zachdeibert/radio-tracker/BOM.xlsx

Part | Part No | Price | Qty Base | Qty Beacon | Qty Extra | Price Base | Price Beacon | Price Extra | Order Link | Datasheet Link
Barometer | MS5637 | $3.40 |  |  | 1 | $0.00 | $0.00 | $3.40 | https://www.digikey.com/product-detail/en/te-connectivity-measurement-specialties/MS563702BA03-50/223-1199-1-ND/4700922 | https://www.te.com/commerce/DocumentDelivery/DDEController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
MCU | ATTINY85 | $0.69 |  | 1 |  | $0.00 | $0.69 | $0.00 | https://www.digikey.com/product-detail/en/microchip-technology/ATTINY85V-15MT/1611-ATTINY85V-15MTCT-ND/6833275 | http://ww1.microchip.com/downloads/en/DeviceDoc/Atmel-7598_Automotive-Microcontrollers-ATtiny25-45-85_Datasheet.pdf
Transmitter | Si4012 | $1.04 |  | 1 |  | $0.00 | $1.04 | $0.00 | https://www.digikey.com/product-detail/en/silicon-labs/SI4012-C1001GTR/336-4153-1-ND/7650432 | https://www.silabs.com/documents/public/data-sheets/Si4012.pdf
Amplifier | MAAL-010704 | $2.83 |  | 1 |  | $0.00 | $2.83 | $0.00 | https://www.digikey.com/product-detail/en/m-a-com-technology-solutions/MAAL-010704-TR3000/1465-1261-1-ND/4429958 | http://cdn.macom.com/datasheets/MAAL-010704.pdf
Buck Converter | AOZ6662D1 | $0.43 | 1 | 1 |  | $0.43 | $0.43 | $0.00 | https://www.digikey.com/product-detail/en/alpha-omega-semiconductor-inc/AOZ6662DI/785-1856-1-ND/10258154 | http://www.aosmd.com/res/data_sheets/AOZ6662DI.pdf
50R Balun | ABT-8 | $0.69 |  | 2 |  | $0.00 | $1.38 | $0.00 | https://www.digikey.com/product-detail/en/abracon-llc/ABT-8-50-1-T/535-12760-1-ND/5043447 | https://abracon.com/Magnetics/balun/ABT-8.pdf
75R Balun | ABT-8 | $0.69 |  |  |  | $0.00 | $0.00 | $0.00 | https://www.digikey.com/product-detail/en/abracon-llc/ABT-8-75-2-T/535-12761-1-ND/5043448 | https://abracon.com/Magnetics/balun/ABT-8.pdf
NPN BJT | MMBT3904 | $0.10 | 1 |  | 1 | $0.10 | $0.00 | $0.10 | https://www.digikey.com/product-detail/en/nexperia-usa-inc/MMBT3904-215/1727-4044-1-ND/1944320 | https://assets.nexperia.com/documents/data-sheet/MMBT3904.pdf
Piezo Buzzer | AT-1224-TWT-5V-2-R | $0.61 | 1 |  | 1 | $0.61 | $0.00 | $0.61 | https://www.digikey.com/product-detail/en/pui-audio-inc/AT-1224-TWT-5V-2-R/668-1470-ND/5011404 | http://www.puiaudio.com/pdf/AT-1224-TWT-5V-2-R.pdf
10-13 MHz Crystal | RH100 | $0.38 |  |  | 1 | $0.00 | $0.00 | $0.38 | https://www.digikey.com/product-detail/en/raltron-electronics/RH100-12-000-12-1010-EXT-TR/2151-RH100-12-000-12-1010-EXT-TRCT-ND/10272643 | http://www.raltron.com/wp-content/uploads/2017/08/RH100_SERIES-August-2017.pdf
Copper Tape | 3483 | $4.95 | 1 |  |  | $4.95 | $0.00 | $0.00 | https://www.digikey.com/product-detail/en/adafruit-industries-llc/3483/1528-2748-ND/9745247 | https://media.digikey.com/pdf/Data%20Sheets/Adafruit%20PDFs/3483_Web.pdf
Card Edge Connector | 5-5530843-0 | $1.98 | 1 |  |  | $1.98 | $0.00 | $0.00 | https://www.digikey.com/product-detail/en/te-connectivity-amp-connectors/5-5530843-0/A31722-ND/770548 | https://www.te.com/commerce/DocumentDelivery/DDEController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
Center-Taped 50R Balun | TC1-1T-152X+ | $0.00 | 1 |  |  | $0.00 | $0.00 | $0.00 | https://www.minicircuits.com/WebStore/dashboard.html?model=TC1-1T-152X%2B | https://www.minicircuits.com/pdfs/TC1-1T-152X+.pdf
MCU | ATMEGA328PB | $1.34 | 1 |  |  | $1.34 | $0.00 | $0.00 | https://www.digikey.com/product-detail/en/microchip-technology/ATMEGA328PB-AU/ATMEGA328PB-AU-ND/5638812 | http://ww1.microchip.com/downloads/en/DeviceDoc/40001907A.pdf | http://ww1.microchip.com/downloads/en/DeviceDoc/40001906C.pdf
DAQ ADC | Si4362-C | $2.39 | 1 |  |  | $2.39 | $0.00 | $0.00 | https://www.digikey.com/product-detail/en/silicon-labs/SI4362-C2A-GM/SI4362-C2A-GM-ND/6165741 | https://www.silabs.com/documents/public/data-sheets/Si4362-C.pdf
IO Expander | PCAL6416A | $1.19 | 1 |  |  | $1.19 | $0.00 | $0.00 | https://www.digikey.com/product-detail/en/nxp-usa-inc/PCAL6416AHF-128/568-9946-1-ND/3721126 | https://www.nxp.com/docs/en/data-sheet/PCAL6416A.pdf
Solid State Relay | CPC1002N | $1.08 | 2 |  |  | $2.16 | $0.00 | $0.00 | https://www.digikey.com/product-detail/en/ixys-integrated-circuits-division/CPC1002N/CLA221-ND/1025047 | http://www.ixysic.com/home/pdfs.nsf/www/CPC1002N.pdf/$file/CPC1002N.pdf
3.3V LDO | MIC5504-3.3YM5-TR | $0.11 |  | 1 |  | $0.00 | $0.11 | $0.00 | https://www.digikey.com/product-detail/en/microchip-technology/MIC5504-3-3YM5-TR/576-4764-1-ND/4864028 | http://ww1.microchip.com/downloads/en/DeviceDoc/MIC5501-02-03-04-300mA-Single-Output-LDO-in-Small-Packages-DS20006006B.pdf
N-Channel MOSFET | DMG2302UK-7 | $0.33 | 1 |  | 1 | $0.33 | $0.00 | $0.33 | https://www.digikey.com/product-detail/en/diodes-incorporated/DMG2302UK-7/DMG2302UK-7DICT-ND/6010163 | https://www.diodes.com/assets/Datasheets/DMG2302UK.pdf
30 MHz Crystal | RH100 | $0.42 | 1 |  |  | $0.42 | $0.00 | $0.00 | https://www.digikey.com/product-detail/en/raltron-electronics/RH100-30-000-10-F-1010-TR/2151-RH100-30-000-10-F-1010-TRCT-ND/10272841 | http://www.raltron.com/wp-content/uploads/2017/08/RH100_SERIES-August-2017.pdf
ISP Header | 75869-131LF | $0.77 | 2 |  |  | $1.54 | $0.00 | $0.00 | https://www.digikey.com/product-detail/en/amphenol-icc-fci/75869-131LF/609-2845-ND/1302569 | https://cdn.amphenol-icc.com/media/wysiwyg/files/drawing/75869.pdf
Battery Clip | 54 | $0.57 | 2 |  |  | $1.14 | $0.00 | $0.00 | https://www.digikey.com/product-detail/en/keystone-electronics/54/36-54-ND/2254090 | https://www.keyelco.com/userAssets/file/M65p11.pdf
LCD | LCD12864 |  | 1 |  |  | $0.00 | $0.00 | $0.00 |  | https://www.exploreembedded.com/wiki/images/7/77/QC12864B.pdf | https://www.waveshare.com/datasheet/LCD_en_PDF/ST7920.pdf
SMA Jack | CON-SMA-EDGE-S | $1.70 | 1 |  |  | $1.70 | $0.00 | $0.00 | https://www.digikey.com/product-detail/en/rf-solutions/CON-SMA-EDGE-S/CON-SMA-EDGE-S-ND/5845767 | https://media.digikey.com/pdf/Data%20Sheets/RF%20Solutions%20PDFs/CON-SMA-EDGE.pdf
Pushbutton | 2-1825910-7 | $0.18 | 12 |  |  | $2.16 | $0.00 | $0.00 | https://www.digikey.com/product-detail/en/te-connectivity-alcoswitch-switches/3-1825910-1/450-1643-ND/1632529 | https://www.te.com/commerce/DocumentDelivery/DDEController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
EEPROM | ~ M24128-BRMN6TP | $0.26 | 1 |  |  | $0.26 | $0.00 | $0.00 | https://www.digikey.com/product-detail/en/stmicroelectronics/M24128-BRMN6TP/497-8619-1-ND/2038663 | https://www.st.com/content/ccc/resource/technical/document/datasheet/59/05/c9/5b/7b/41/48/b6/CD00259167.pdf/files/CD00259167.pdf/jcr:content/translations/en.C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
Power Switch | OS102011MA1QN1 | $0.48 | 1 |  |  | $0.48 | $0.00 | $0.00 | https://www.digikey.com/product-detail/en/c-k/OS102011MA1QN1/CKN9559-ND/1981430 | https://www.ckswitches.com/media/1428/os.pdf
Voltage Reference | MCP1501T-30E/CHY | $0.76 | 1 |  |  | $0.76 | $0.00 | $0.00 | https://www.digikey.com/product-detail/en/microchip-technology/MCP1501T-30E-CHY/MCP1501T-30E-CHYCT-ND/5844633 | http://ww1.microchip.com/downloads/en/DeviceDoc/20005474E.pdf
Trimmer | TC33X-2-103E | $0.28 | 1 |  |  | $0.28 | $0.00 | $0.00 | https://www.digikey.com/product-detail/en/bourns-inc/TC33X-2-103E/TC33X-103ECT-ND/612911 | https://www.bourns.com/docs/Product-Datasheets/TC33.pdf
Programming Cable - AD2 Side | 65846-002LF | $3.48 | 1 |  |  | $3.48 | $0.00 | $0.00 | https://www.digikey.com/product-detail/en/amphenol-icc-fci/65846-002LF/609-3540-ND/1525281
Programming Cable - AD2 Side | 47649-000LF | $0.12 | 25 |  |  | $3.10 | $0.00 | $0.00 | https://www.digikey.com/product-detail/en/amphenol-icc-fci/47649-000LF/609-3614-1-ND/2044035
Programming Cable - AVR Side | 71600-006LF | $0.78 | 2 |  |  | $1.56 | $0.00 | $0.00 | https://www.digikey.com/product-detail/en/amphenol-icc-fci/71600-006LF/609-2841-ND/1302571
I2C Header | 640456-3 | $0.14 | 1 |  |  | $0.14 | $0.00 | $0.00 | https://www.digikey.com/product-detail/en/te-connectivity-amp-connectors/640456-3/A19470-ND/259010 | https://www.te.com/commerce/DocumentDelivery/DDEController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
Programming Cable - I2C Side | 3-640441-3 | $0.22 | 1 |  |  | $0.22 | $0.00 | $0.00 | https://www.digikey.com/product-detail/en/te-connectivity-amp-connectors/3-640441-3/A30979-ND/698222
Programming Cable - I2C Side | 643075-4 | $0.45 | 1 |  |  | $0.45 | $0.00 | $0.00 | https://www.digikey.com/product-detail/en/te-connectivity-amp-connectors/643075-4/A19232-ND/258868
RAM | 47L16-I/SN | $0.70 | 1 |  |  | $0.70 | $0.00 | $0.00 | https://www.digikey.com/product-detail/en/microchip-technology/47L16-I-SN/47L16-I-SN-ND/6098090 | http://ww1.microchip.com/downloads/en/DeviceDoc/47L04_47C04_47L16_47C16_DS20005371D.pdf
80mA PTC | 0ZCM0008FF2G | $0.16 | 1 |  | 1 | $0.16 | $0.00 | $0.16 | https://www.digikey.com/product-detail/en/bel-fuse-inc/0ZCM0008FF2G/507-1817-1-ND/4156262 | https://belfuse.com/resources/datasheets/circuitprotection/ds-cp-0zcm-series.pdf
140mA PTC | 0ZCG0014FF2C | $0.14 | 1 |  |  | $0.14 | $0.00 | $0.00 | https://www.digikey.com/product-detail/en/bel-fuse-inc/0ZCG0014FF2C/507-1755-1-ND/4156193 | https://www.belfuse.com/resources/datasheets/circuitprotection/ds-cp-0zcg-series.pdf
50mA PTC | 0ZCM0005FF2G | $0.16 | 5 |  |  | $0.80 | $0.00 | $0.00 | https://www.digikey.com/product-detail/en/bel-fuse-inc/0ZCM0005FF2G/507-1816-1-ND/4156260 | https://belfuse.com/resources/datasheets/circuitprotection/ds-cp-0zcm-series.pdf
