zachdeibert/radio-tracker/beacon.brd

## EAGLE design beacon.brd (2020-06-22)

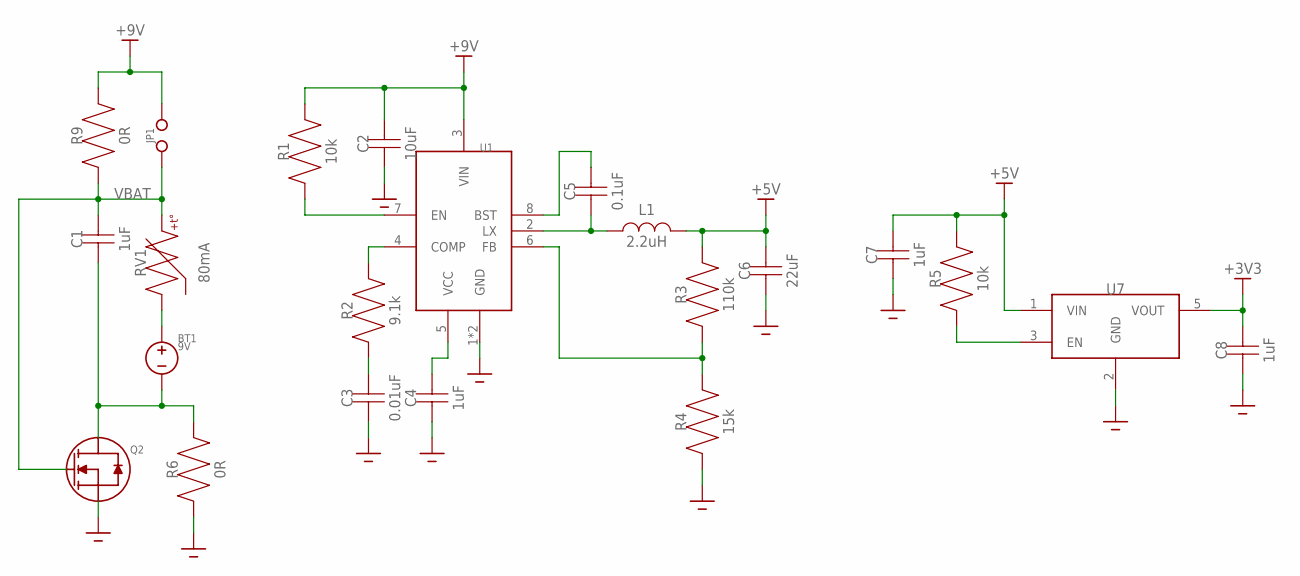
[picture p1: schematic beacon.sch, sheet 1, Power]

Parts:
BT1: 9V; JUMPER
C1, C4, C7, C8: 1uF; 0603
C2: 10uF; 0805
C3: 0.01uF; 0603
C5: 0.1uF; 0603
C6: 22uF; 0805
JP1: JUMPER
L1: 2.2uH; 0805
Q2: DMG2302UK
R1, R5: 10k; 0603
R2: 9.1k; 0603
R3: 110k; 0603
R4: 15k; 0603
R6, R9: 0R; 0805
RV1: 80mA; 0603
U1: AOZ6662DI
U7: MIC5504

Connections:
+3V3: C8.P$2, U7.5 (VOUT); also elsewhere on the board
+5V: C6.P$2, C7.P$2, L1.P$2, R3.P$2, R5.P$2, U7.1 (VIN); also elsewhere on the board
+9V: C2.P$2, JP1.2, R1.P$2, R9.P$2, U1.3 (VIN); also elsewhere on the board
GND: C2.P$1, C3.P$1, C4.P$1, C6.P$1, C7.P$1, C8.P$1, Q2.2 (S), R4.P$1, R6.P$1, U1.1 (GND), U1.9 (GND), U7.2 (GND); also elsewhere on the board
unnamed: R2.P$2, U1.4 (COMP)
unnamed: R1.P$1, U1.7 (EN)
unnamed: C3.P$2, R2.P$1
unnamed: C4.P$2, U1.5 (VCC)
unnamed: C5.P$2, U1.8 (BST)
unnamed: C5.P$1, L1.P$1, U1.2 (LX)
unnamed: R3.P$1, R4.P$2, U1.6 (FB)
unnamed: BT1.1, C1.P$1, Q2.3 (D), R6.P$2
unnamed: R5.P$1, U7.3 (EN)
unnamed: BT1.2, RV1.P$1
VBAT: C1.P$2, JP1.1, Q2.1 (G), R9.P$1, RV1.P$2; also elsewhere on the board

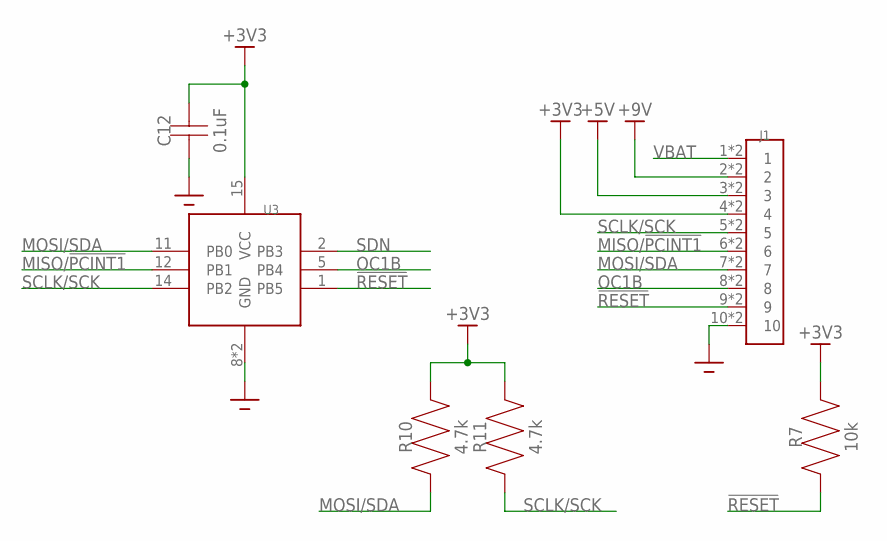
[picture p2: schematic beacon.sch, sheet 2, MCU]

Parts:
C12: 0.1uF; 0603
J1: 5-5530843-0MALE; 5-5530843-0-M
R7: 10k; 0603
R10, R11: 4.7k; 0603
U3: ATTINY85

Connections:
!RESET: J1.9, J1.19 (9), R7.P$1, U3.1 (PB5)
+3V3: C12.P$2, J1.4, J1.14 (4), R7.P$2, R10.P$2, R11.P$2, U3.15 (VCC); also elsewhere on the board
+5V: J1.3, J1.13 (3); also elsewhere on the board
+9V: J1.2, J1.12 (2); also elsewhere on the board
GND: C12.P$1, J1.10, J1.20 (10), U3.8 (GND), U3.21 (GND); also elsewhere on the board
MISO/!PCINT1: J1.6, J1.16 (6), U3.12 (PB1); also elsewhere on the board
MOSI/SDA: J1.7, J1.17 (7), R10.P$1, U3.11 (PB0); also elsewhere on the board
OC1B: J1.8, J1.18 (8), U3.5 (PB4); also elsewhere on the board
SCLK/SCK: J1.5, J1.15 (5), R11.P$1, U3.14 (PB2); also elsewhere on the board
SDN: U3.2 (PB3); also elsewhere on the board
VBAT: J1.1, J1.11 (1); also elsewhere on the board

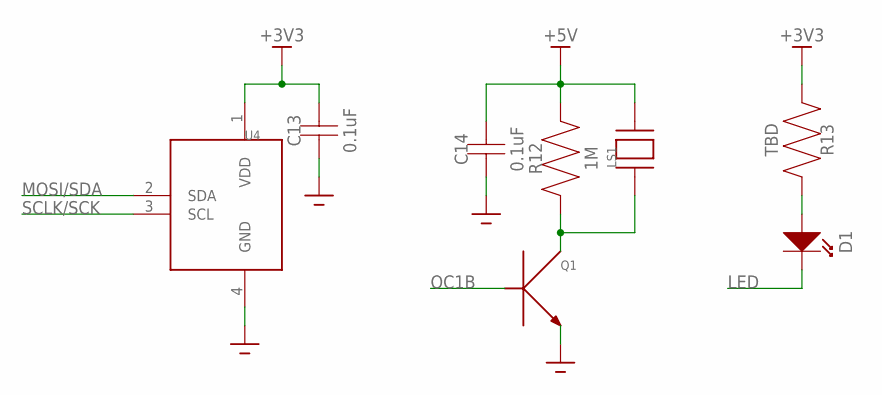
[picture p3: schematic beacon.sch, sheet 3, Extras]

Parts:
C13, C14: 0.1uF; 0603
D1: LED; 0805
LS1: AT-1224-TWT-5V-2-R
Q1: MMBT3904
R12: 1M; 0603
R13: TBD; 0603
U4: MS5637-02BA03

Connections:
+3V3: C13.P$2, R13.P$1, U4.1 (VDD); also elsewhere on the board
+5V: C14.P$2, LS1.2, R12.P$2; also elsewhere on the board
GND: C13.P$1, C14.P$1, Q1.2 (E), U4.4 (GND); also elsewhere on the board
LED: D1.P$2 (OUT); also elsewhere on the board
MOSI/SDA: U4.2 (SDA); also elsewhere on the board
unnamed: LS1.1, Q1.3 (C), R12.P$1
unnamed: D1.P$1 (IN), R13.P$2
OC1B: Q1.1 (B); also elsewhere on the board
SCLK/SCK: U4.3 (SCL); also elsewhere on the board

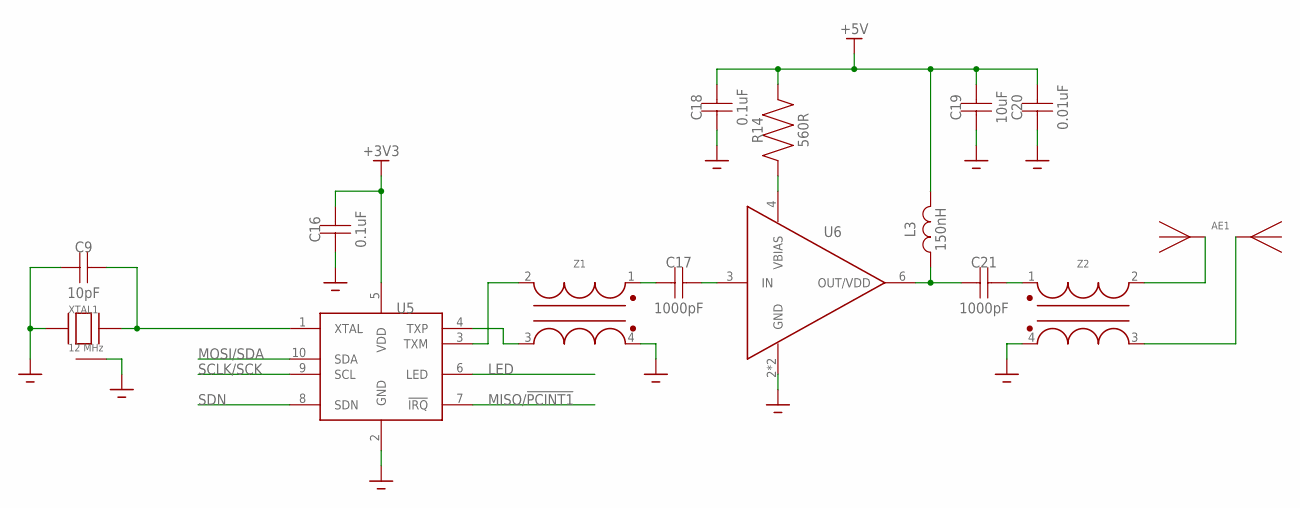
[picture p4: schematic beacon.sch, sheet 4, RF]

Parts:
AE1: ANTENNA
C9: 10pF; 0603
C16, C18: 0.1uF; 0603
C17, C21: 1000pF; 0402
C19: 10uF; 0603
C20: 0.01uF; 0603
L3: 150nH; 0402
R14: 560R; 0603
U5: SI4012
U6: MAAL-010704
XTAL1: 12 MHz; RH100
Z1, Z2: ABT-8

Connections:
+3V3: C16.P$2, U5.5 (VDD); also elsewhere on the board
+5V: C18.P$2, C19.P$2, C20.P$2, L3.2, R14.P$2; also elsewhere on the board
GND: C9.P$1, C16.P$1, C18.P$1, C19.P$1, C20.P$1, U5.2 (GND), U6.2 (GND), U6.5 (GND), XTAL1.1 (GND), XTAL1.2, XTAL1.3 (GND), Z1.4 (UN2), Z2.4 (UN2); also elsewhere on the board
LED: U5.6 (LED); also elsewhere on the board
MISO/!PCINT1: U5.7 (!IRQ); also elsewhere on the board
MOSI/SDA: U5.10 (SDA); also elsewhere on the board
unnamed: U5.4 (TXP), Z1.3 (BAL2)
unnamed: U5.3 (TXM), Z1.2 (BAL1)
unnamed: C9.P$2, U5.1 (XTAL), XTAL1.4
unnamed: C21.1, L3.1, U6.6 (OUT/VDD)
unnamed: C17.1, Z1.1 (UN1)
unnamed: C17.2, U6.3 (IN)
unnamed: R14.P$1, U6.4 (VBIAS)
unnamed: C21.2, Z2.1 (UN1)
unnamed: AE1.LB, AE1.LT, Z2.2 (BAL1)
unnamed: AE1.RB, AE1.RT, Z2.3 (BAL2)
SCLK/SCK: U5.9 (SCL); also elsewhere on the board
SDN: U5.8 (SDN); also elsewhere on the board

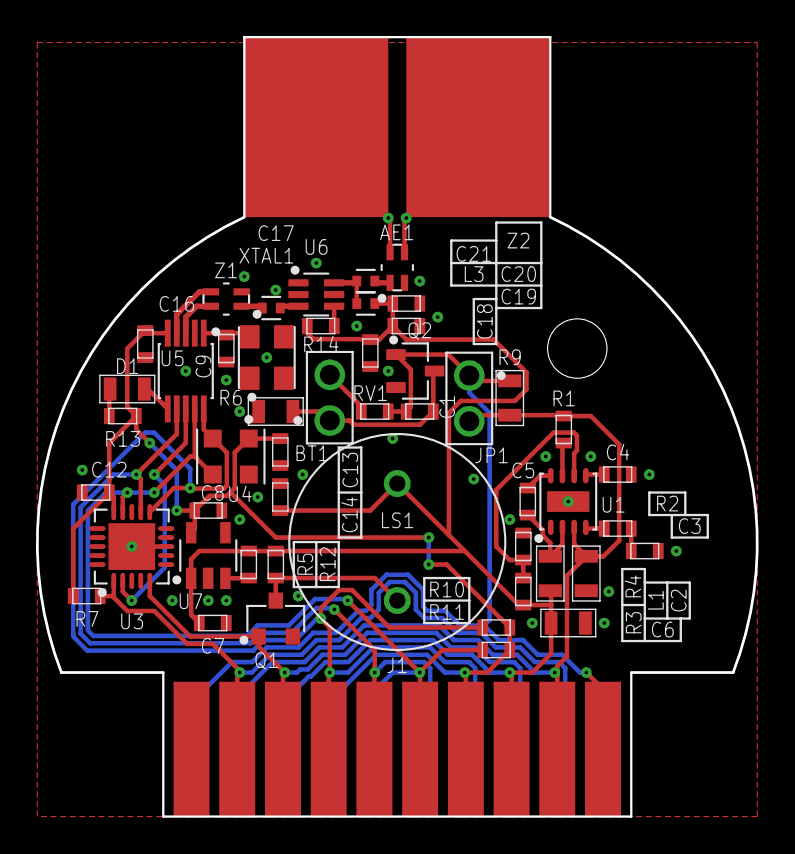
[picture p5: board beacon.brd from above]

Board: 2 copper layers, 40.0 x 43.3 mm, 51 parts (1 on the bottom side), 34 nets.
