zachdeibert/radio-tracker/tracker.brd

## EAGLE design tracker.brd (2020-06-22)

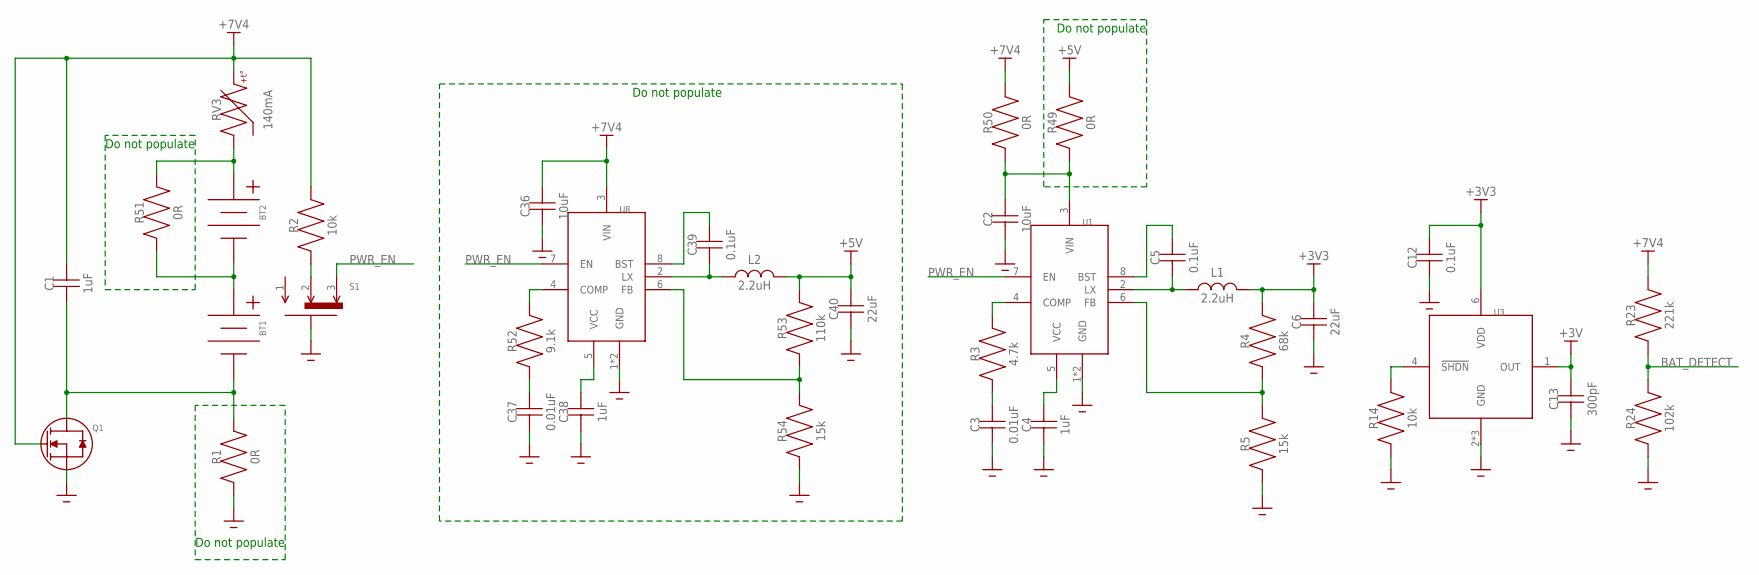
[picture p6: schematic tracker.sch, sheet 1, Power]

Parts:
BT1, BT2: 18650
C1, C4, C38: 1uF; 0603
C2, C36: 10uF; 0805
C3, C37: 0.01uF; 0603
C5, C12, C39: 0.1uF; 0603
C6, C40: 22uF; 0805
C13: 300pF; 0603
L1, L2: 2.2uH; 0805
Q1: DMG2302UK
R1, R49, R50, R51: 0R; 0603
R2, R14: 10k; 0603
R3: 4.7k; 0603
R4: 68k; 0603
R5, R54: 15k; 0603
R23: 221k; 0603
R24: 102k; 0603
R52: 9.1k; 0603
R53: 110k; 0603
RV3: 140mA; 1812
S1: OS102011MA1QN1
U1, U8: AOZ6662DI
U3: MCP1501; SOT95P280X145-6N

Connections:
+3V: C13.P$2, U3.1 (OUT); also elsewhere on the board
+3V3: C6.P$2, C12.P$2, L1.P$2, R4.P$2, U3.6 (VDD); also elsewhere on the board
+5V: C40.P$2, L2.P$2, R49.P$2, R53.P$2; also elsewhere on the board
+7V4V: C1.P$2, C36.P$2, Q1.1 (G), R2.P$2, R23.P$2, R50.P$2, RV3.P$2, U8.3 (VIN)
BAT_DETECT: R23.P$1, R24.P$2; also elsewhere on the board
GND: C2.P$1, C3.P$1, C4.P$1, C6.P$1, C12.P$1, C13.P$1, C36.P$1, C37.P$1, C38.P$1, C40.P$1, Q1.2 (S), R1.P$1, R5.P$1, R14.P$1, R24.P$1, R54.P$1, S1.S1 (GND), S1.S2 (GND), U1.1 (GND), U1.9 (GND), U3.2 (GND), U3.3 (GND), U3.5 (GND), U8.1 (GND), U8.9 (GND); also elsewhere on the board
unnamed: BT1.-1 (-), BT1.-2 (-), BT1.-3 (-), C1.P$1, Q1.3 (D), R1.P$2
unnamed: R3.P$2, U1.4 (COMP)
unnamed: BT1.+1 (+), BT1.+2 (+), BT1.+3 (+), BT2.-1 (-), BT2.-2 (-), BT2.-3 (-), R51.P$1
unnamed: C3.P$2, R3.P$1
unnamed: C4.P$2, U1.5 (VCC)
unnamed: C5.P$2, U1.8 (BST)
unnamed: C5.P$1, L1.P$1, U1.2 (LX)
unnamed: R4.P$1, R5.P$2, U1.6 (FB)
unnamed: R2.P$1, S1.2
unnamed: R14.P$2, U3.4 (!SHDN)
unnamed: R52.P$2, U8.4 (COMP)
unnamed: C2.P$2, R49.P$1, R50.P$1, U1.3 (VIN)
unnamed: C37.P$2, R52.P$1
unnamed: C38.P$2, U8.5 (VCC)
unnamed: C39.P$2, U8.8 (BST)
unnamed: C39.P$1, L2.P$1, U8.2 (LX)
unnamed: R53.P$1, R54.P$2, U8.6 (FB)
unnamed: BT2.+1 (+), BT2.+2 (+), BT2.+3 (+), R51.P$2, RV3.P$1
PWR_EN: S1.3, U1.7 (EN), U8.7 (EN)

Notes on the sheet:
Do not populate

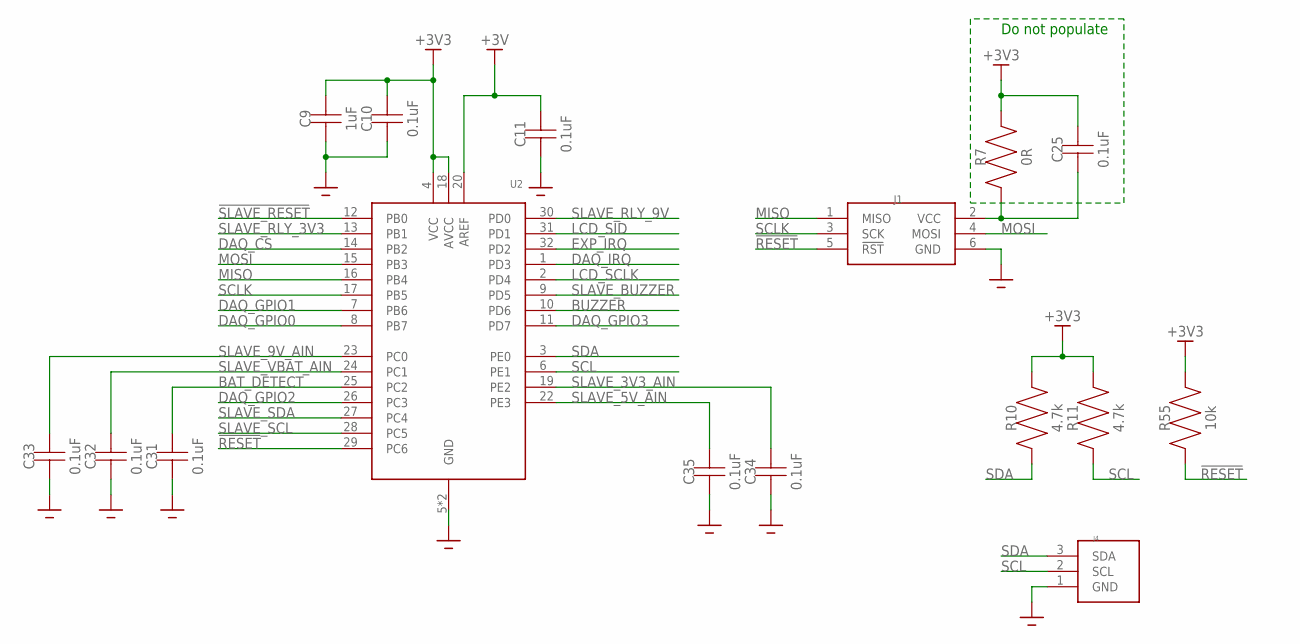
[picture p7: schematic tracker.sch, sheet 2, MCU]

Parts:
C9: 1uF; 0603
C10, C11, C25, C31, C32, C33, C34, C35: 0.1uF; 0603
J1: 75869-131LF
J4: 640456-3
R7: 0R; 0603
R10, R11: 4.7k; 0603
R55: 10k; 0603
U2: ATMEGA328PB32-TQFP; ATMEGA328PB

Connections:
!RESET: J1.5 (!RST), R55.P$1, U2.29 (PC6)
!SLAVE_RESET: U2.12 (PB0); also elsewhere on the board
+3V: C11.P$2, U2.20 (AREF); also elsewhere on the board
+3V3: C9.P$2, C10.P$2, C25.P$2, R7.P$2, R10.P$2, R11.P$2, R55.P$2, U2.4 (VCC), U2.18 (AVCC); also elsewhere on the board
BAT_DETECT: C31.P$2, U2.25 (PC2); also elsewhere on the board
BUZZER: U2.10 (PD6); also elsewhere on the board
DAQ_CS: U2.14 (PB2); also elsewhere on the board
DAQ_GPIO0: U2.8 (PB7); also elsewhere on the board
DAQ_GPIO1: U2.7 (PB6); also elsewhere on the board
DAQ_GPIO2: U2.26 (PC3); also elsewhere on the board
DAQ_GPIO3: U2.11 (PD7); also elsewhere on the board
DAQ_IRQ: U2.1 (PD3); also elsewhere on the board
EXP_IRQ: U2.32 (PD2); also elsewhere on the board
GND: C9.P$1, C10.P$1, C11.P$1, C31.P$1, C32.P$1, C33.P$1, C34.P$1, C35.P$1, J1.6 (GND), J4.1 (GND), U2.5 (GND), U2.21 (GND); also elsewhere on the board
LCD_SCLK: U2.2 (PD4); also elsewhere on the board
LCD_SID: U2.31 (PD1); also elsewhere on the board
MISO: J1.1 (MISO), U2.16 (PB4); also elsewhere on the board
MOSI: J1.4 (MOSI), U2.15 (PB3); also elsewhere on the board
unnamed: C25.P$1, J1.2 (VCC), R7.P$1
SCL: J4.2 (SCL), R11.P$1, U2.6 (PE1); also elsewhere on the board
SCLK: J1.3 (SCK), U2.17 (PB5); also elsewhere on the board
SDA: J4.3 (SDA), R10.P$1, U2.3 (PE0); also elsewhere on the board
SLAVE_3V3_AIN: C34.P$2, U2.19 (PE2); also elsewhere on the board
SLAVE_5V_AIN: C35.P$2, U2.22 (PE3); also elsewhere on the board
SLAVE_9V_AIN: C33.P$2, U2.23 (PC0); also elsewhere on the board
SLAVE_BUZZER: U2.9 (PD5); also elsewhere on the board
SLAVE_RLY_3V3: U2.13 (PB1); also elsewhere on the board
SLAVE_RLY_9V: U2.30 (PD0); also elsewhere on the board
SLAVE_SCL: U2.28 (PC5); also elsewhere on the board
SLAVE_SDA: U2.27 (PC4); also elsewhere on the board
SLAVE_VBAT_AIN: C32.P$2, U2.24 (PC1); also elsewhere on the board

Notes on the sheet:
Do not populate

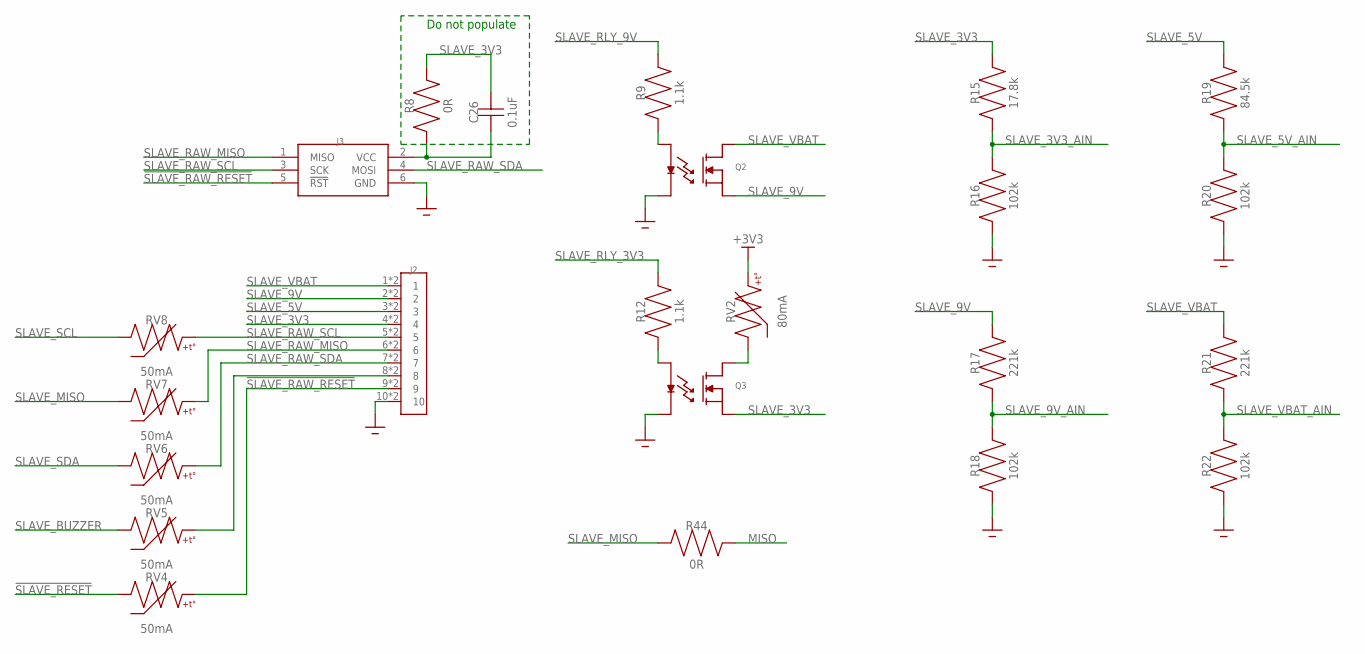
[picture p8: schematic tracker.sch, sheet 3, Slave Port]

Parts:
C26: 0.1uF; 0603
J2: 5-5530843-0FEMALE; 5-5530843-0
J3: 75869-131LF
Q2, Q3: CPC1002N
R8, R44: 0R; 0603
R9, R12: 1.1k; 0603
R15: 17.8k; 0603
R16, R18, R20, R22: 102k; 0603
R17, R21: 221k; 0603
R19: 84.5k; 0603
RV2: 80mA; 0603
RV4, RV5, RV6, RV7, RV8: 50mA; 0603

Connections:
!SLAVE_RAW_RESET: J2.9, J2.19 (9), J3.5 (!RST), RV4.P$2
!SLAVE_RESET: RV4.P$1; also elsewhere on the board
+3V3: RV2.P$2; also elsewhere on the board
GND: J2.10, J2.20 (10), J3.6 (GND), Q2.2 (C-), Q3.2 (C-), R16.P$1, R18.P$1, R20.P$1, R22.P$1; also elsewhere on the board
MISO: R44.P$2; also elsewhere on the board
unnamed: Q3.4 (DC+), RV2.P$1
unnamed: C26.P$1, J3.2 (VCC), R8.P$1
unnamed: Q3.1 (C+), R12.P$1
unnamed: Q2.1 (C+), R9.P$1
unnamed: J2.8, J2.18 (8), RV5.P$2
SLAVE_3V3: C26.P$2, J2.4, J2.14 (4), Q3.3 (DC-), R8.P$2, R15.P$2
SLAVE_3V3_AIN: R15.P$1, R16.P$2; also elsewhere on the board
SLAVE_5V: J2.3, J2.13 (3), R19.P$2
SLAVE_5V_AIN: R19.P$1, R20.P$2; also elsewhere on the board
SLAVE_9V: J2.2, J2.12 (2), Q2.3 (DC-), R17.P$2
SLAVE_9V_AIN: R17.P$1, R18.P$2; also elsewhere on the board
SLAVE_BUZZER: RV5.P$1; also elsewhere on the board
SLAVE_MISO: R44.P$1, RV7.P$1
SLAVE_RAW_MISO: J2.6, J2.16 (6), J3.1 (MISO), RV7.P$2
SLAVE_RAW_SCL: J2.5, J2.15 (5), J3.3 (SCK), RV8.P$2
SLAVE_RAW_SDA: J2.7, J2.17 (7), J3.4 (MOSI), RV6.P$2
SLAVE_RLY_3V3: R12.P$2; also elsewhere on the board
SLAVE_RLY_9V: R9.P$2; also elsewhere on the board
SLAVE_SCL: RV8.P$1; also elsewhere on the board
SLAVE_SDA: RV6.P$1; also elsewhere on the board
SLAVE_VBAT: J2.1, J2.11 (1), Q2.4 (DC+), R21.P$2
SLAVE_VBAT_AIN: R21.P$1, R22.P$2; also elsewhere on the board

Notes on the sheet:
Do not populate

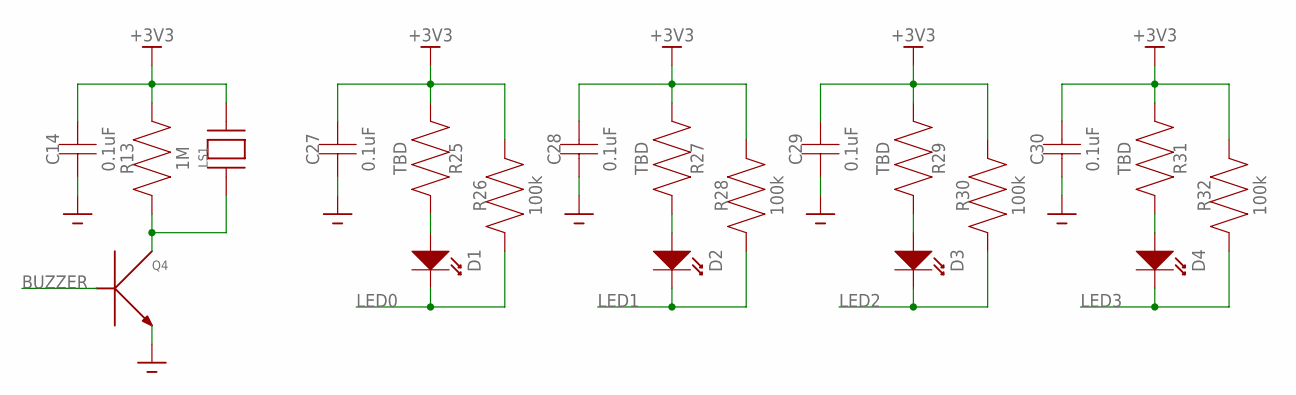
[picture p9: schematic tracker.sch, sheet 4, Buzzer and LEDs]

Parts:
C14, C27, C28, C29, C30: 0.1uF; 0603
D1, D2, D3, D4: LED; 0805
LS1: AT-1224-TWT-5V-2-R
Q4: MMBT3904
R13: 1M; 0603
R25, R27, R29, R31: TBD; 0603
R26, R28, R30, R32: 100k; 0603

Connections:
+3V3: C14.P$2, C27.P$2, C28.P$2, C29.P$2, C30.P$2, LS1.2, R13.P$2, R25.P$1, R26.P$2, R27.P$1, R28.P$2, R29.P$1, R30.P$2, R31.P$1, R32.P$2; also elsewhere on the board
BUZZER: Q4.1 (B); also elsewhere on the board
GND: C14.P$1, C27.P$1, C28.P$1, C29.P$1, C30.P$1, Q4.2 (E); also elsewhere on the board
LED0: D1.P$2 (OUT), R26.P$1; also elsewhere on the board
LED1: D2.P$2 (OUT), R28.P$1; also elsewhere on the board
LED2: D3.P$2 (OUT), R30.P$1; also elsewhere on the board
LED3: D4.P$2 (OUT), R32.P$1; also elsewhere on the board
unnamed: D2.P$1 (IN), R27.P$2
unnamed: D3.P$1 (IN), R29.P$2
unnamed: D1.P$1 (IN), R25.P$2
unnamed: D4.P$1 (IN), R31.P$2
unnamed: LS1.1, Q4.3 (C), R13.P$1

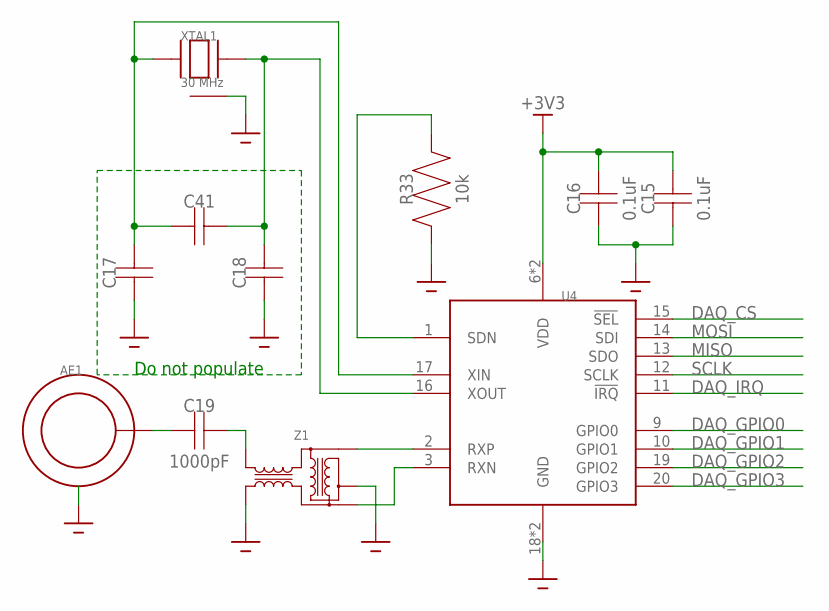
[picture p10: schematic tracker.sch, sheet 5, RF]

Parts:
AE1: CON-SMA-EDGE-S
C15, C16: 0.1uF; 0603
C17, C18, C41: CAPACITOR0603; 0603
C19: 1000pF; 0402
R33: 10k; 0603
U4: SI4362
XTAL1: 30 MHz; RH100
Z1: TC1-1T-152X+

Connections:
+3V3: C15.P$2, C16.P$2, U4.6 (VDD), U4.8 (VDD); also elsewhere on the board
DAQ_CS: U4.15 (!SEL); also elsewhere on the board
DAQ_GPIO0: U4.9 (GPIO0); also elsewhere on the board
DAQ_GPIO1: U4.10 (GPIO1); also elsewhere on the board
DAQ_GPIO2: U4.19 (GPIO2); also elsewhere on the board
DAQ_GPIO3: U4.20 (GPIO3); also elsewhere on the board
DAQ_IRQ: U4.11 (!IRQ); also elsewhere on the board
GND: AE1.GND1 (GND), AE1.GND2 (GND), AE1.GND3 (GND), AE1.GND4 (GND), C15.P$1, C16.P$1, C17.P$1, C18.P$1, R33.P$1, U4.18 (GND), U4.21 (GND), XTAL1.1 (GND), XTAL1.3 (GND), Z1.2 (CENTER), Z1.4 (GND); also elsewhere on the board
MISO: U4.13 (SDO); also elsewhere on the board
MOSI: U4.14 (SDI); also elsewhere on the board
unnamed: R33.P$2, U4.1 (SDN)
unnamed: AE1.CENTER (OUT), C19.1
unnamed: C17.P$2, C41.P$1, U4.17 (XIN), XTAL1.2
unnamed: U4.3 (RXN), Z1.3 (BAL2)
unnamed: U4.2 (RXP), Z1.1 (BAL1)
unnamed: C18.P$2, C41.P$2, U4.16 (XOUT), XTAL1.4
unnamed: C19.2, Z1.6 (UNBAL)
SCLK: U4.12 (SCLK); also elsewhere on the board

Notes on the sheet:
Do not populate

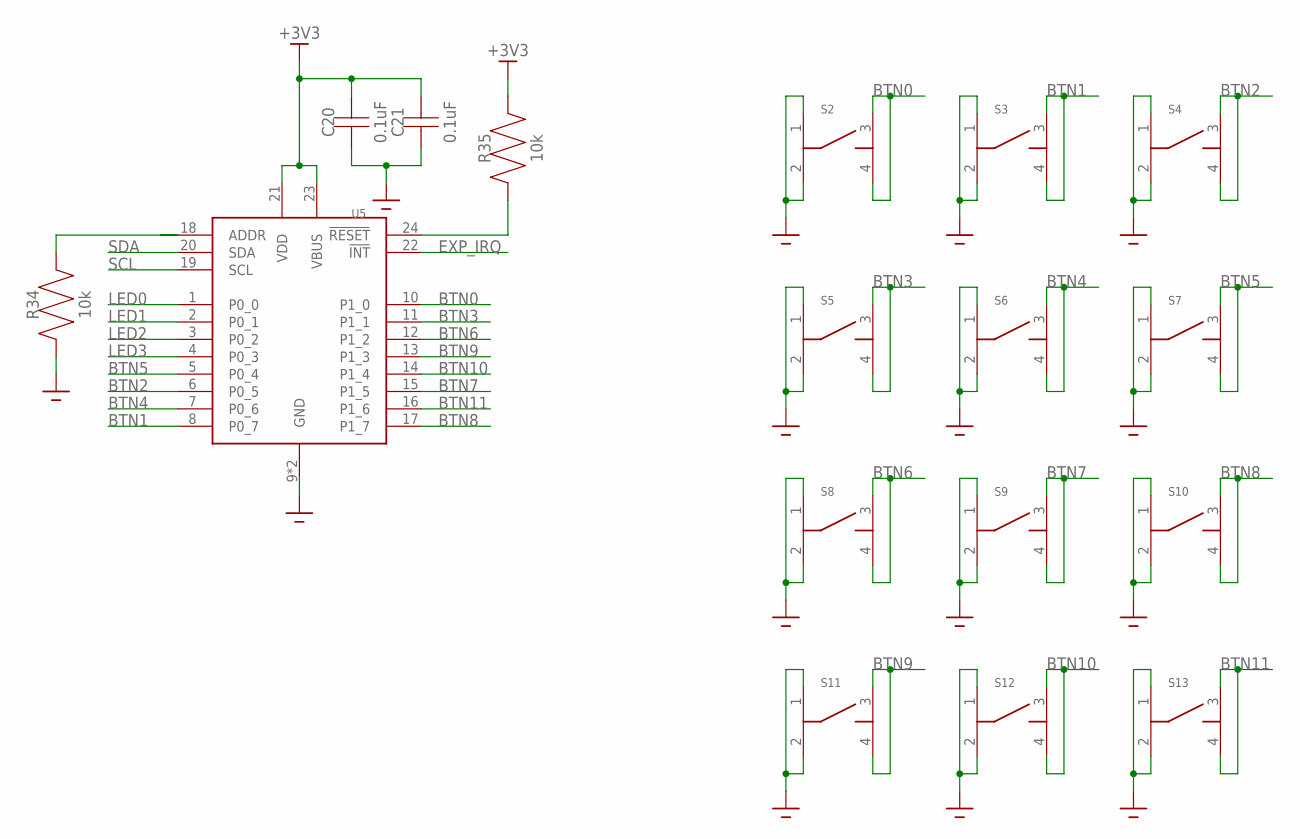
[picture p11: schematic tracker.sch, sheet 6, Pin Pad]

Parts:
C20, C21: 0.1uF; 0603
R34, R35: 10k; 0603
S2, S3, S4, S5, S6, S7, S8, S9, S10, S11, S12, S13: 3-1825910
U5: PCAL6416

Connections:
+3V3: C20.P$2, C21.P$2, R35.P$2, U5.21 (VDD), U5.23 (VBUS); also elsewhere on the board
BTN0: S2.3 (4), S2.4 (3), U5.10 (P1_0)
BTN1: S3.3 (4), S3.4 (3), U5.8 (P0_7)
BTN2: S4.3 (4), S4.4 (3), U5.6 (P0_5)
BTN3: S5.3 (4), S5.4 (3), U5.11 (P1_1)
BTN4: S6.3 (4), S6.4 (3), U5.7 (P0_6)
BTN5: S7.3 (4), S7.4 (3), U5.5 (P0_4)
BTN6: S8.3 (4), S8.4 (3), U5.12 (P1_2)
BTN7: S9.3 (4), S9.4 (3), U5.15 (P1_5)
BTN8: S10.3 (4), S10.4 (3), U5.17 (P1_7)
BTN9: S11.3 (4), S11.4 (3), U5.13 (P1_3)
BTN10: S12.3 (4), S12.4 (3), U5.14 (P1_4)
BTN11: S13.3 (4), S13.4 (3), U5.16 (P1_6)
EXP_IRQ: U5.22 (!INT); also elsewhere on the board
GND: C20.P$1, C21.P$1, R34.P$1, S2.1, S2.2, S3.1, S3.2, S4.1, S4.2, S5.1, S5.2, S6.1, S6.2, S7.1, S7.2, S8.1, S8.2, S9.1, S9.2, S10.1, S10.2, S11.1, S11.2, S12.1, S12.2, S13.1, S13.2, U5.9 (GND), U5.25 (GND); also elsewhere on the board
LED0: U5.1 (P0_0); also elsewhere on the board
LED1: U5.2 (P0_1); also elsewhere on the board
LED2: U5.3 (P0_2); also elsewhere on the board
LED3: U5.4 (P0_3); also elsewhere on the board
unnamed: R35.P$1, U5.24 (!RESET)
unnamed: R34.P$2, U5.18 (ADDR)
SCL: U5.19 (SCL); also elsewhere on the board
SDA: U5.20 (SDA); also elsewhere on the board

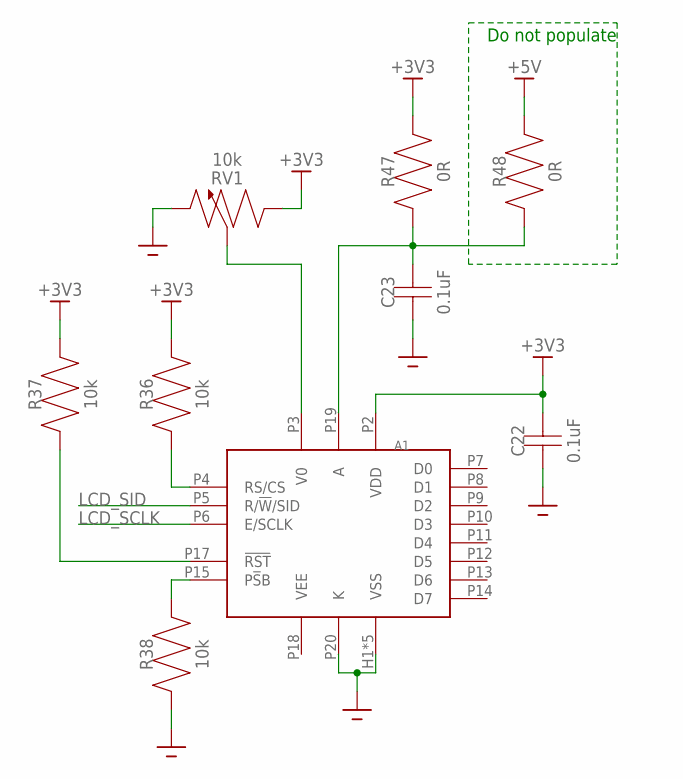
[picture p12: schematic tracker.sch, sheet 7, LCD]

Parts:
A1: LCD12864
C22, C23: 0.1uF; 0603
R36, R37, R38: 10k; 0603
R47, R48: 0R; 0603
RV1: 10k; TC33X-2

Connections:
+3V3: A1.P2 (VDD), C22.P$2, R36.P$2, R37.P$2, R47.P$2, RV1.1 (CCW); also elsewhere on the board
+5V: R48.P$2; also elsewhere on the board
GND: A1.H1 (VSS), A1.H2 (VSS), A1.H3 (VSS), A1.H4 (VSS), A1.P1 (VSS), A1.P20 (K), C22.P$1, C23.P$1, R38.P$1, RV1.3 (CW); also elsewhere on the board
LCD_SCLK: A1.P6 (E/SCLK); also elsewhere on the board
LCD_SID: A1.P5 (R/!W!/SID); also elsewhere on the board
unnamed: A1.P4 (RS/CS), R36.P$1
unnamed: A1.P17 (!RST), R37.P$1
unnamed: A1.P15 (P!S!B), R38.P$2
unnamed: A1.P3 (V0), RV1.2 (WIPER)
unnamed: A1.P19 (A), C23.P$2, R47.P$1, R48.P$1
VEE: A1.P18 (VEE)

Notes on the sheet:
Do not populate

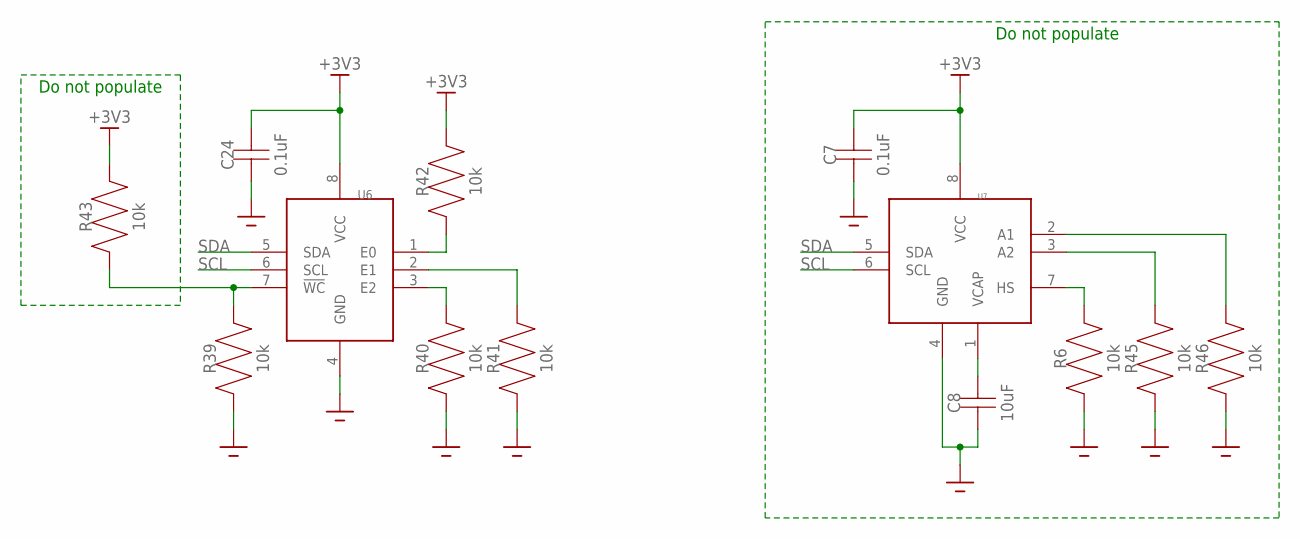
[picture p13: schematic tracker.sch, sheet 8, EEPROM]

Parts:
C7, C24: 0.1uF; 0603
C8: 10uF; 0805
R6, R39, R40, R41, R42, R43, R45, R46: 10k; 0603
U6: M24
U7: 47L16

Connections:
+3V3: C7.P$2, C24.P$2, R42.P$2, R43.P$2, U6.8 (VCC), U7.8 (VCC); also elsewhere on the board
GND: C7.P$1, C8.P$1, C24.P$1, R6.P$1, R39.P$1, R40.P$1, R41.P$1, R45.P$1, R46.P$1, U6.4 (GND), U7.4 (GND); also elsewhere on the board
unnamed: R42.P$1, U6.1 (E0)
unnamed: R39.P$2, R43.P$1, U6.7 (!WC)
unnamed: R40.P$2, U6.3 (E2)
unnamed: R41.P$2, U6.2 (E1)
unnamed: R6.P$2, U7.7 (HS)
unnamed: C8.P$2, U7.1 (VCAP)
unnamed: R45.P$2, U7.3 (A2)
unnamed: R46.P$2, U7.2 (A1)
SCL: U6.6 (SCL), U7.6 (SCL); also elsewhere on the board
SDA: U6.5 (SDA), U7.5 (SDA); also elsewhere on the board

Notes on the sheet:
Do not populate

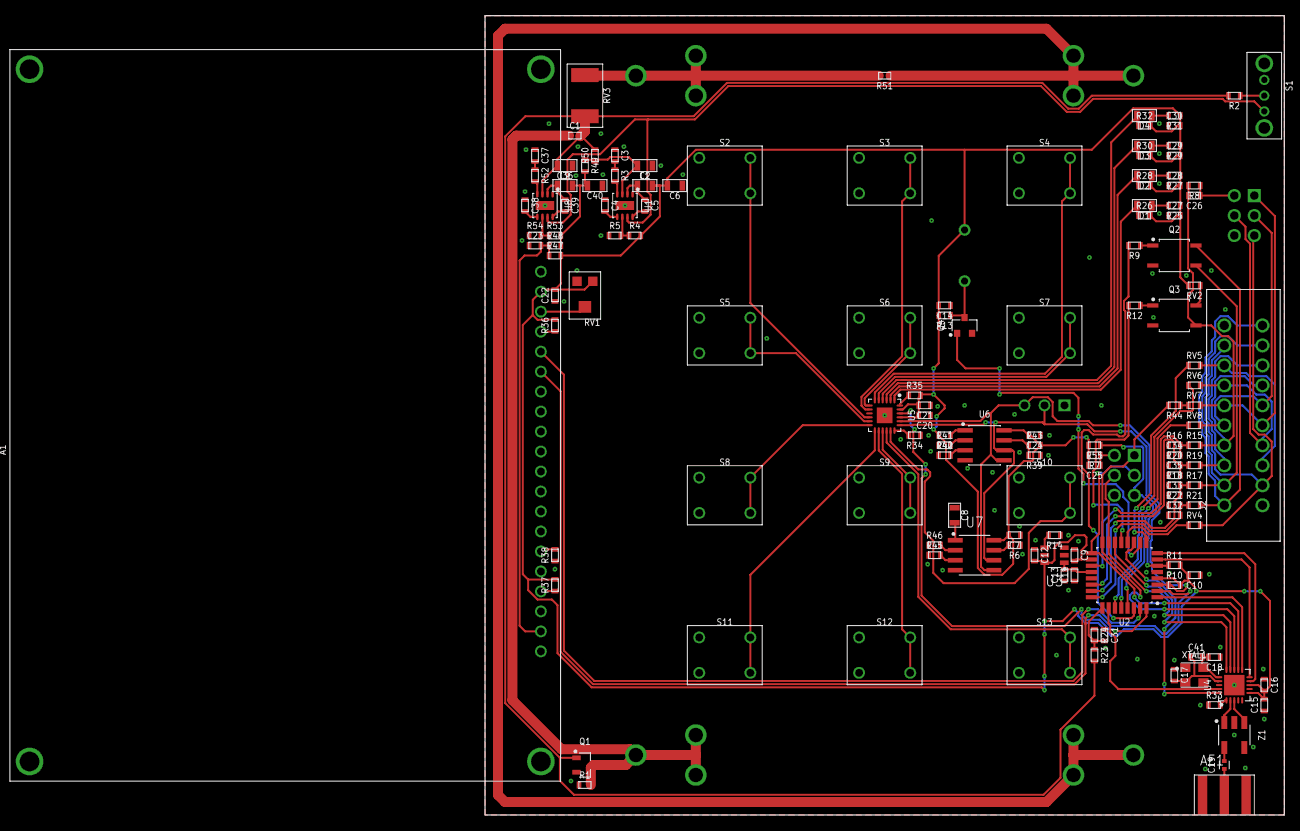
[picture p14: board tracker.brd from above]

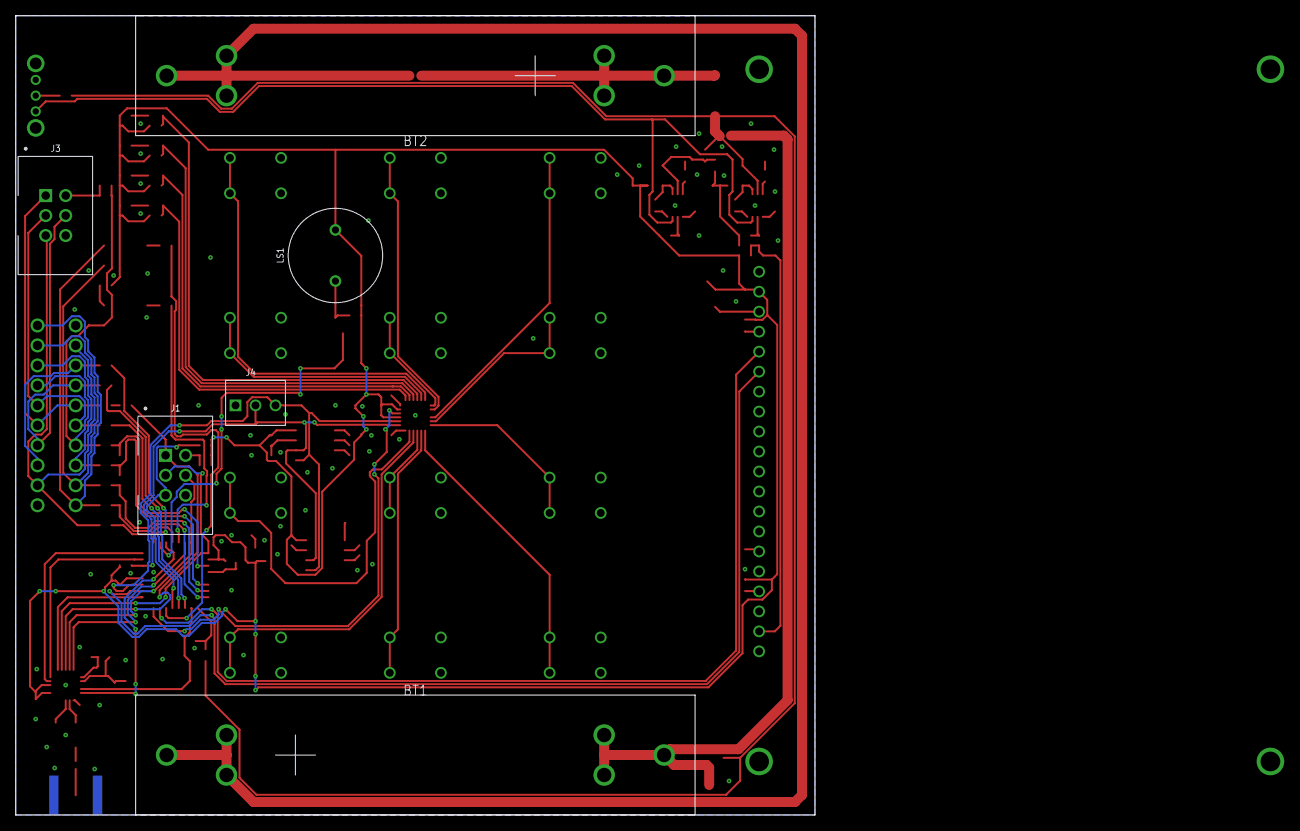
[picture p15: board tracker.brd from below]

Board: 2 copper layers, 101.6 x 101.6 mm, 146 parts (6 on the bottom side), 109 nets.
