zachdeibert/radio-tracker/(commit log)

2020-05-21 Created initial schematic for beacon
    [BOM.xlsx, beacon.sch]
2020-05-22 Initial version of tracker schematic
    [BOM.xlsx, Pin Mapping.xlsx, beacon.sch, tracker.sch]
2020-05-23 Various schematic updates
    [BOM.xlsx, beacon.sch, tracker.sch]
2020-05-26 A few schematic updates
    [BOM.xlsx, Pin Mapping.xlsx, tracker.sch]
2020-06-21 First routing attempt
    [beacon.brd, beacon.sch]
2020-06-21 Routed beacon
    [BOM.xlsx, beacon.brd, beacon.sch, tracker.sch]
2020-06-21 Fixed silk screen on beacon
    [beacon.brd]
2020-06-21 Added PTC fuse
    [BOM.xlsx, beacon.brd, beacon.sch]
2020-06-22 Layed out tracker board
    [BOM.xlsx, Pin Mapping.xlsx, beacon.brd, beacon.sch, tracker.brd, tracker.sch]
